ademuri/air-filter-controller/hardware/air-filter-controller.kicad_pcb

## KiCad design hardware/air-filter-controller.kicad_pcb (2025-01-30)

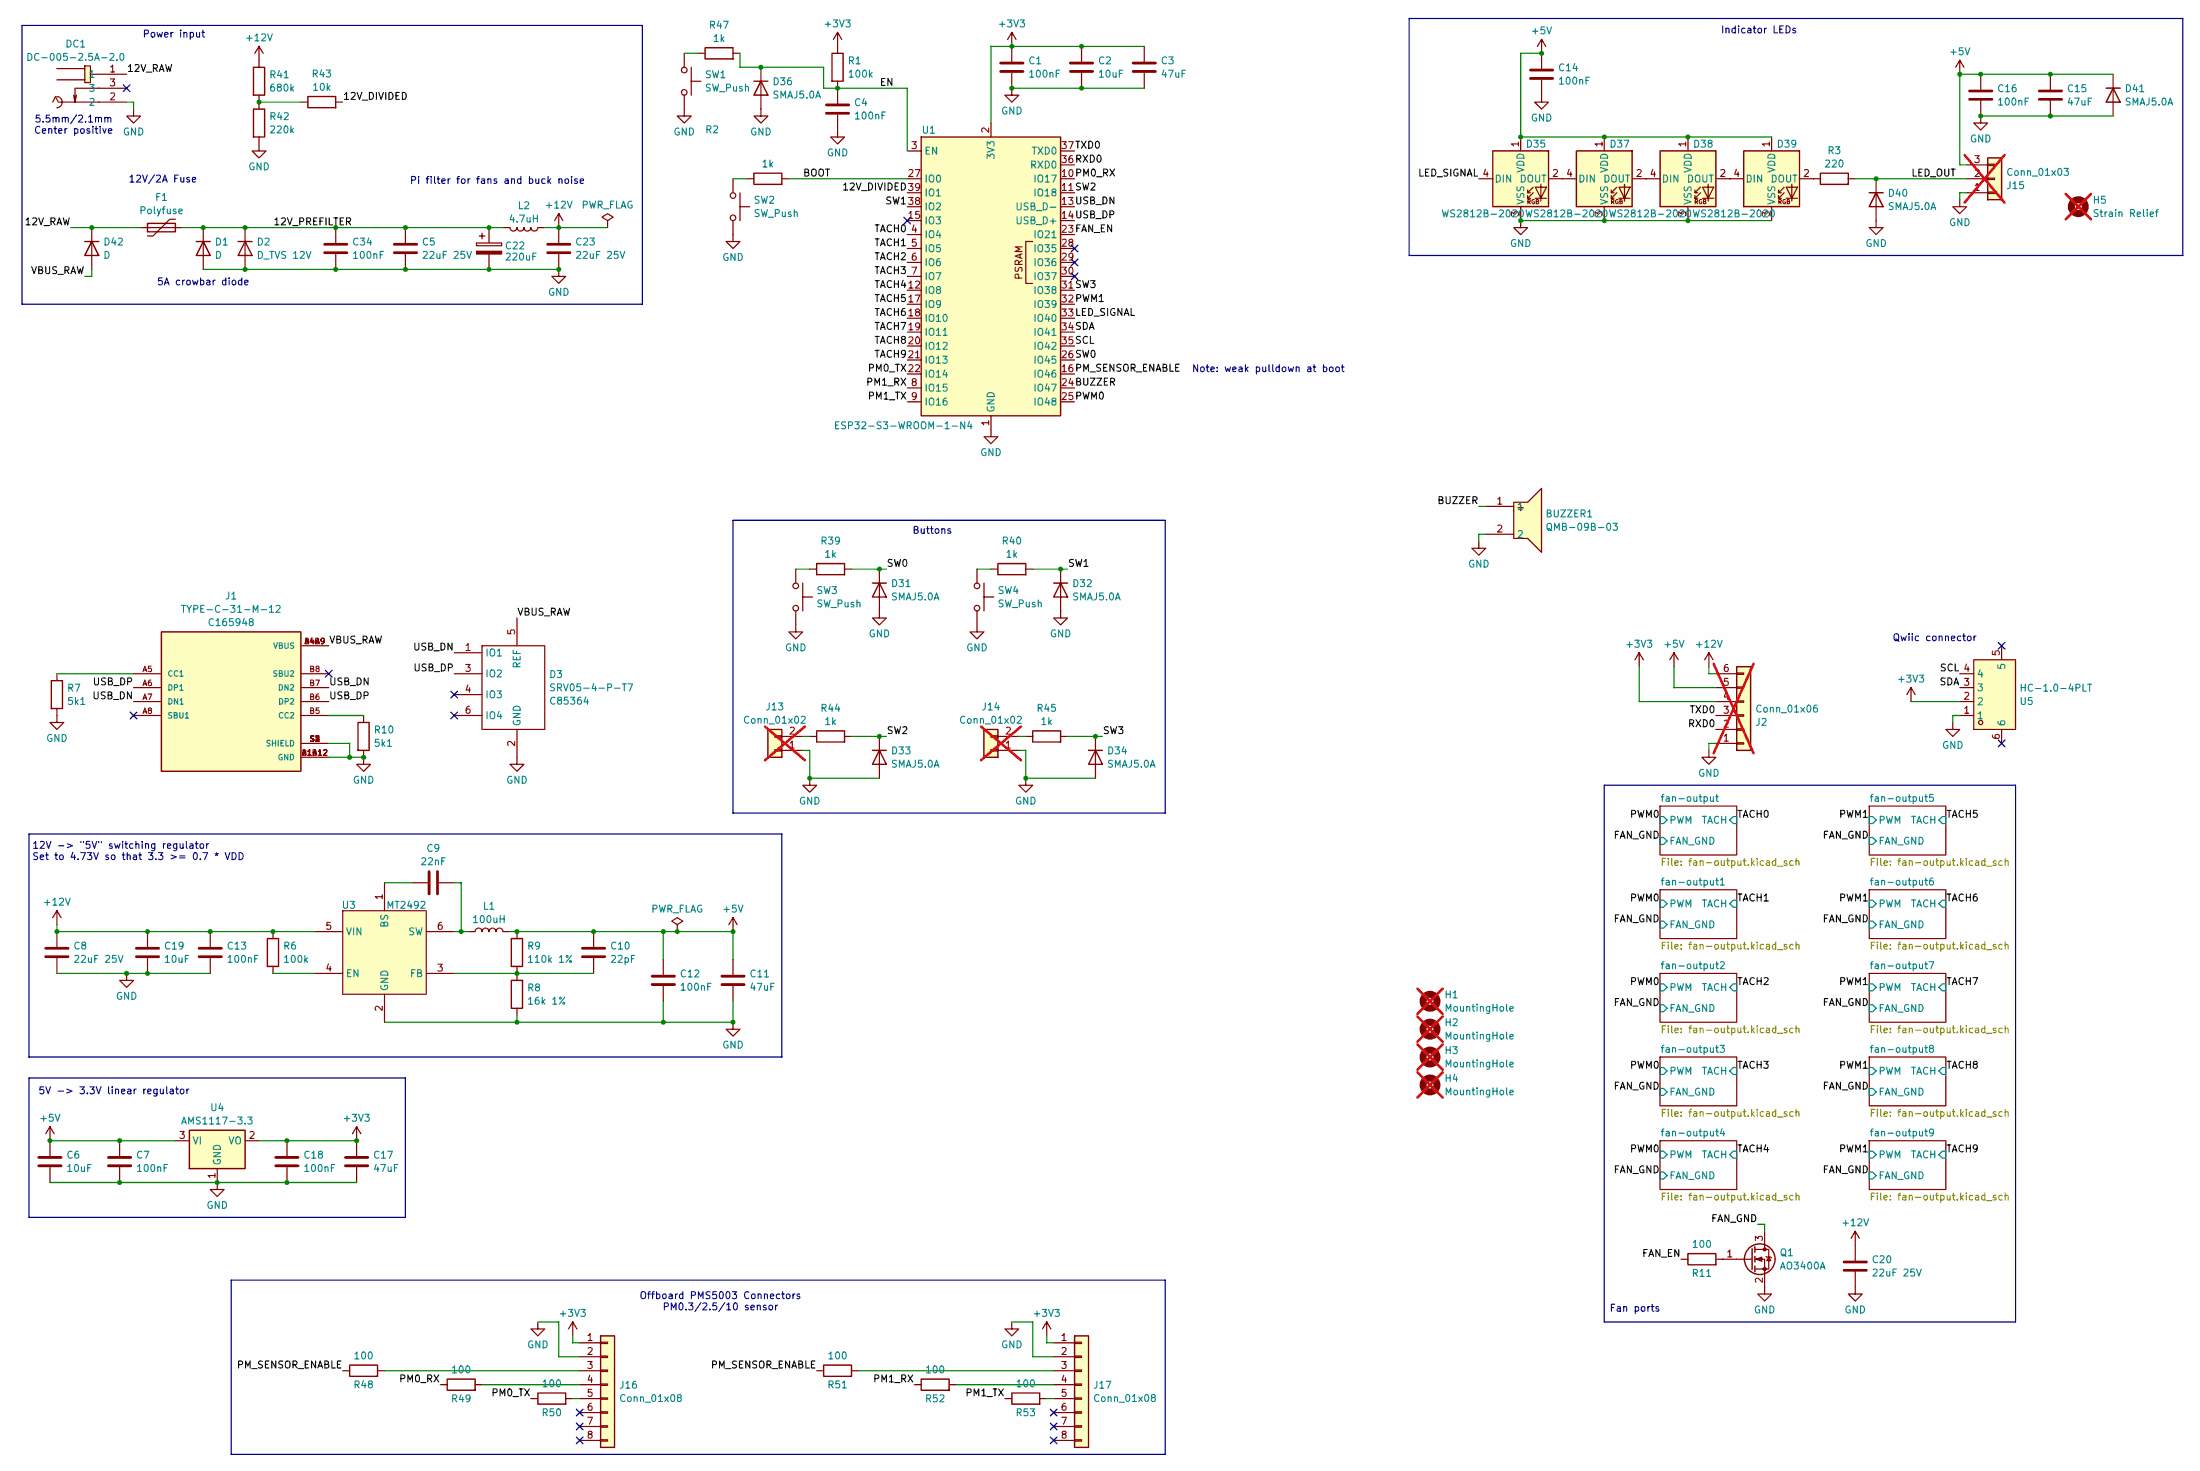
[picture p1: schematic air-filter-controller.kicad_sch]

Parts:
BUZZER1: QMB-09B-03; BUZ-TH_BD9.0-P4.00-D0.6-FD; LCSC C96256
C1, C4, C7, C12, C13, C14, C16, C18, C34: 100nF; C_0402_1005Metric; LCSC C307331
C2, C6, C19: 10uF; C_0603_1608Metric; LCSC C96446
C3, C11, C15, C17: 47uF; C_1206_3216Metric; LCSC C96123
C5, C8, C20, C23: 22uF 25V; C_1206_3216Metric; LCSC C12891
C9: 22nF; C_0402_1005Metric; LCSC C1532
C10: 22pF; C_0402_1005Metric; LCSC C1555
C22: 220uF; CP_Elec_8x10; LCSC C134765
D1, D42: D; D_SMA; MPN SS54; LCSC C22452
D2: D_TVS 12V; D_SMA; MPN SMAJ12A-E3/61; LCSC C89613
D3: SRV05-4-P-T7; SOT-23-6; LCSC C85364
D31, D32, D33, D34, D36, D40, D41: SMAJ5.0A; D_SMA; MPN SMAJ5.0A; LCSC C113952
D35, D37, D38, D39: WS2812B-2020; LED-SMD_4P-L2.0-W2.0-TL_WS2812B-2020; LCSC C965555
DC1: DC-005-2.5A-2.0; CONN-TH_DC-005-2.5A-2.0; LCSC C319099
F1: Polyfuse; Fuse_1812_4532Metric; MPN 1812L200/12DR; LCSC C315901
H1, H2, H3, H4: MountingHole; MountingHole_3.2mm_M3_ISO7380; not fitted
H5: Strain Relief; 3_pin_2.54mm_pitch_strain_relief; not fitted
J1: TYPE-C-31-M-12; HRO_TYPE-C-31-M-12; PARTREV A; LCSC C165948
J2: Conn_01x06; PinHeader_1x06_P2.54mm_Vertical; not fitted
J13, J14: Conn_01x02; PinHeader_1x02_P2.54mm_Vertical; not fitted
J15: Conn_01x03; PinHeader_1x03_P2.54mm_Vertical; not fitted
J16, J17: Conn_01x08; CONN-TH_8P-P1.25_HCTL_HC-1.25-8A; LCSC C2845526
L1: 100uH; L_Sunlord_SWPA8040S; MPN SWPA8065S101MT; LCSC C334254
L2: 4.7uH; L_Sunlord_SWPA4030S; MPN SWPA4030S4R7MT; LCSC C57269
Q1: AO3400A; SOT-23; LCSC C20917
R1, R6: 100k; R_0402_1005Metric; LCSC C25741
R2, R39, R40, R44, R45, R47: 1k; R_0402_1005Metric; LCSC C11702
R3: 220; R_0603_1608Metric_Pad0.98x0.95mm_HandSolder; LCSC C22962
R7, R10: 5k1; R_0402_1005Metric; LCSC C25905
R8: 16k 1%; R_0402_1005Metric; LCSC C25759
R9: 110k 1%; R_0402_1005Metric; LCSC C25745
R11: 100; R_0402_1005Metric; LCSC C25076
R41: 680k; R_0402_1005Metric; LCSC C4131
R42: 220k; R_0402_1005Metric; LCSC C25767
R43: 10k; R_0402_1005Metric; LCSC C25744
R48, R49, R50, R51, R52, R53: 100; R_0603_1608Metric_Pad0.98x0.95mm_HandSolder; LCSC C22775
SW1, SW2, SW3, SW4: SW_Push; SW_TACTILE_5.1MM_TS-1187A-C-D-B; LCSC C318884
U1: ESP32-S3-WROOM-1-N4; ESP32-S3-WROOM-1; LCSC C2913197
U3: MT2492; SOT-23-6_L2.9-W1.6-P0.95-LS2.8-BL; LCSC C89358
U4: AMS1117-3.3; SOT-223-3_TabPin2; LCSC C6186
U5: HC-1.0-4PLT; CONN-SMD_4P-P1.00_HC-1.0-4PLT; LCSC C2845372

Connections:
+3V3: C1.1, C2.1, C3.1, C17.1, C18.1, J2.4, J16.1, J17.1, R1.1, U1.2 (3V3), U4.2 (VO), U5.2; also elsewhere on the board
+5V: C6.1, C7.1, C10.2, C11.1, C12.1, C14.1, C15.1, C16.1, D35.1 (VDD), D37.1 (VDD), D38.1 (VDD), D39.1 (VDD), D41.1 (K), J2.5, J15.3, L1.2, R9.1, U4.3 (VI)
+12V: C8.1, C13.1, C19.1, C20.1, C23.1, J2.6, L2.1, R6.1, R41.1, U3.5 (VIN); also elsewhere on the board
/12V_DIVIDED: R43.2, U1.39 (IO1)
/12V_PREFILTER: C5.1, C22.1, C34.1, D1.1 (K), D2.1 (K), F1.2, L2.2
/12V_RAW: D42.1 (K), DC1.1, F1.1
/BOOT: R2.2, U1.27 (IO0)
/BUZZER: BUZZER1.1, U1.24 (IO47)
/EN: C4.1, D36.1 (K), R1.2, R47.2, U1.3 (EN)
/FAN_EN: R11.1, U1.23 (IO21)
/FAN_GND: Q1.3 (D); also elsewhere on the board
/LED_OUT: D40.1 (K), J15.2, R3.2
/LED_SIGNAL: D35.4 (DIN), U1.33 (IO40)
/PM0_RX: R49.1, U1.10 (IO17)
/PM0_TX: R50.1, U1.22 (IO14)
/PM1_RX: R52.1, U1.8 (IO15)
/PM1_TX: R53.1, U1.9 (IO16)
/PM_SENSOR_ENABLE: R48.1, R51.1, U1.16 (IO46)
/PWM0: U1.25 (IO48); also elsewhere on the board
/PWM1: U1.32 (IO39); also elsewhere on the board
/RXD0: J2.2, U1.36 (RXD0)
/SCL: U1.35 (IO42), U5.4
/SDA: U1.34 (IO41), U5.3
/SW0: D31.1 (K), R39.2, U1.26 (IO45)
/SW1: D32.1 (K), R40.2, U1.38 (IO2)
/SW2: D33.1 (K), R44.2, U1.11 (IO18)
/SW3: D34.1 (K), R45.2, U1.31 (IO38)
/TACH0: U1.4 (IO4); also elsewhere on the board
/TACH1: U1.5 (IO5); also elsewhere on the board
/TACH2: U1.6 (IO6); also elsewhere on the board
/TACH3: U1.7 (IO7); also elsewhere on the board
/TACH4: U1.12 (IO8); also elsewhere on the board
/TACH5: U1.17 (IO9); also elsewhere on the board
/TACH6: U1.18 (IO10); also elsewhere on the board
/TACH7: U1.19 (IO11); also elsewhere on the board
/TACH8: U1.20 (IO12); also elsewhere on the board
/TACH9: U1.21 (IO13); also elsewhere on the board
/TXD0: J2.3, U1.37 (TXD0)
/USB_DN: D3.1 (IO1), J1.A7 (DN1), J1.B7 (DN2), U1.13 (USB_D-)
/USB_DP: D3.3 (IO2), J1.A6 (DP1), J1.B6 (DP2), U1.14 (USB_D+)
/VBUS_RAW: D3.5 (REF), D42.2 (A), J1.A4B9 (VBUS), J1.B4A9 (VBUS)
GND: BUZZER1.2, C1.2, C2.2, C3.2, C4.2, C5.2, C6.2, C7.2, C8.2, C11.2, C12.2, C13.2, C14.2, C15.2, C16.2, C17.2, C18.2, C19.2, C20.2, C22.2, C23.2, C34.2, D1.2 (A), D2.2 (A), D3.2 (GND), D31.2 (A), D32.2 (A), D33.2 (A), D34.2 (A), D35.3 (VSS), D36.2 (A), D37.3 (VSS), D38.3 (VSS), D39.3 (VSS), D40.2 (A), D41.2 (A), DC1.2, J1.A1B12 (GND), J1.B1A12 (GND), J1.S1 (SHIELD), J1.S2 (SHIELD), J1.S3 (SHIELD), J1.S4 (SHIELD), J2.1, J13.1, J14.1, J15.1, J16.2, J17.2, Q1.2 (S), R7.2, R8.1, R10.2, R42.2, SW1.2, SW2.2, SW3.2, SW4.2, U1.1 (GND), U1.40 (GND), U1.41 (GND), U3.2 (GND), U4.1 (GND), U5.1; also elsewhere on the board
unnamed: D35.2 (DOUT), D37.4 (DIN)
unnamed: D37.2 (DOUT), D38.4 (DIN)
unnamed: D38.2 (DOUT), D39.4 (DIN)
unnamed: D39.2 (DOUT), R3.1
unnamed: J1.A5 (CC1), R7.1
unnamed: J1.B5 (CC2), R10.1
unnamed: J13.2, R44.1
unnamed: J14.2, R45.1
unnamed: J16.3, R48.2
unnamed: J16.4, R49.2
unnamed: J16.5, R50.2
unnamed: J17.3, R51.2
unnamed: J17.4, R52.2
unnamed: J17.5, R53.2
unnamed: Q1.1 (G), R11.2
unnamed: R2.1, SW2.1
unnamed: R39.1, SW3.1
unnamed: R40.1, SW4.1
unnamed: R41.2, R42.1, R43.1
unnamed: R47.1, SW1.1
unnamed: C9.1, U3.1 (BS)
unnamed: R6.2, U3.4 (EN)
unnamed: C10.1, R8.2, R9.2, U3.3 (FB)
unnamed: C9.2, L1.1, U3.6 (SW)

Notes on the sheet:
Power input
Fan ports
Note: weak pulldown at boot
Pi filter for fans and buck noise
5.5mm/2.1mm Center positive
5V -> 3.3V linear regulator
Qwiic connector
12V -> "5V" switching regulator Set to 4.73V so that 3.3 >= 0.7 * VDD
Offboard PMS5003 Connectors PM0.3/2.5/10 sensor
5A crowbar diode
12V/2A Fuse
Indicator LEDs
Buttons

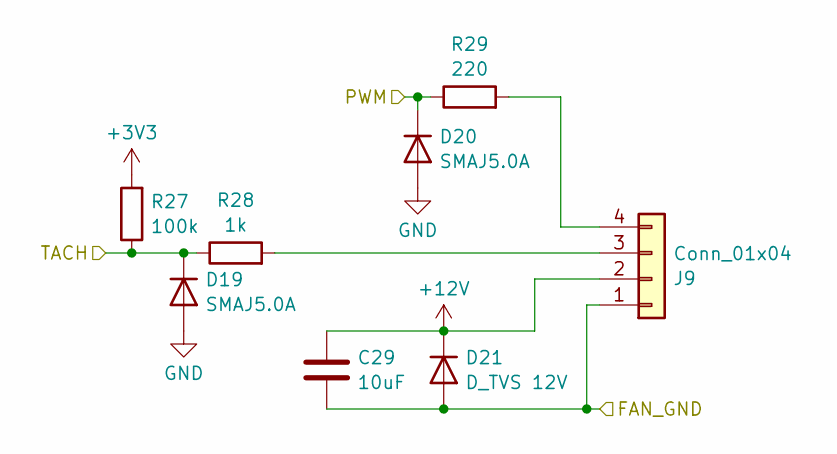
[picture p2: schematic fan-output.kicad_sch]

Parts:
C29: 10uF; C_0603_1608Metric; LCSC C96446
D19, D20: SMAJ5.0A; D_SMA; MPN SMAJ5.0A; LCSC C113952
D21: D_TVS 12V; D_SMA; MPN SMAJ12A-E3/61; LCSC C89613
J9: Conn_01x04; CONN-TH_47053-1000; MPN 470531000; LCSC C240840
R27: 100k; R_0603_1608Metric_Pad0.98x0.95mm_HandSolder; LCSC C25803
R28: 1k; R_0402_1005Metric; LCSC C11702
R29: 220; R_0603_1608Metric_Pad0.98x0.95mm_HandSolder; LCSC C22962

Connections:
+3V3: R27.2; also elsewhere on the board
+12V: C29.1, D21.1 (K), J9.2; also elsewhere on the board
/FAN_GND: C29.2, D21.2 (A), J9.1; also elsewhere on the board
/PWM1: D20.1 (K), R29.1; also elsewhere on the board
/TACH5: D19.1 (K), R27.1, R28.1; also elsewhere on the board
GND: D19.2 (A), D20.2 (A); also elsewhere on the board
unnamed: J9.3, R28.2
unnamed: J9.4, R29.2

Parts of its further copies:
C24, C25, C26, C27, C28, C30, C31, C32, C33: 10uF; C_0603_1608Metric; LCSC C96446
D4, D9, D12, D15, D18, D24, D27, D30, D45: D_TVS 12V; D_SMA; MPN SMAJ12A-E3/61; LCSC C89613
D5, D6, D7, D8, D10, D11, D13, D14, D16, D17, D22, D23, D25, D26, D28, D29, D43, D44: SMAJ5.0A; D_SMA; MPN SMAJ5.0A; LCSC C113952
J3, J4, J5, J6, J7, J8, J10, J11, J12: Conn_01x04; CONN-TH_47053-1000; MPN 470531000; LCSC C240840
R4, R12, R15, R18, R21, R24, R30, R33, R36: 100k; R_0603_1608Metric_Pad0.98x0.95mm_HandSolder; LCSC C25803
R5, R13, R16, R19, R22, R25, R31, R34, R37: 1k; R_0402_1005Metric; LCSC C11702
R14, R17, R20, R23, R26, R32, R35, R38, R46: 220; R_0603_1608Metric_Pad0.98x0.95mm_HandSolder; LCSC C22962

Connections of its further copies:
+3V3: R4.2, R12.2, R15.2, R18.2, R21.2, R24.2, R30.2, R33.2, R36.2; also elsewhere on the board
+12V: C24.1, C25.1, C26.1, C27.1, C28.1, C30.1, C31.1, C32.1, C33.1, D4.1 (K), D9.1 (K), D12.1 (K), D15.1 (K), D18.1 (K), D24.1 (K), D27.1 (K), D30.1 (K), D45.1 (K), J3.2, J4.2, J5.2, J6.2, J7.2, J8.2, J10.2, J11.2, J12.2; also elsewhere on the board
/FAN_GND: C24.2, C25.2, C26.2, C27.2, C28.2, C30.2, C31.2, C32.2, C33.2, D4.2 (A), D9.2 (A), D12.2 (A), D15.2 (A), D18.2 (A), D24.2 (A), D27.2 (A), D30.2 (A), D45.2 (A), J3.1, J4.1, J5.1, J6.1, J7.1, J8.1, J10.1, J11.1, J12.1; also elsewhere on the board
/PWM0: D6.1 (K), D8.1 (K), D11.1 (K), D14.1 (K), D17.1 (K), R14.1, R17.1, R20.1, R23.1, R26.1; also elsewhere on the board
/PWM1: D23.1 (K), D26.1 (K), D29.1 (K), D44.1 (K), R32.1, R35.1, R38.1, R46.1; also elsewhere on the board
/TACH0: D5.1 (K), R13.1, R15.1; also elsewhere on the board
/TACH1: D7.1 (K), R12.1, R16.1; also elsewhere on the board
/TACH2: D10.1 (K), R18.1, R19.1; also elsewhere on the board
/TACH3: D13.1 (K), R21.1, R22.1; also elsewhere on the board
/TACH4: D16.1 (K), R24.1, R25.1; also elsewhere on the board
/TACH6: D22.1 (K), R30.1, R31.1; also elsewhere on the board
/TACH7: D25.1 (K), R33.1, R34.1; also elsewhere on the board
/TACH8: D28.1 (K), R36.1, R37.1; also elsewhere on the board
/TACH9: D43.1 (K), R4.1, R5.1; also elsewhere on the board
GND: D5.2 (A), D6.2 (A), D7.2 (A), D8.2 (A), D10.2 (A), D11.2 (A), D13.2 (A), D14.2 (A), D16.2 (A), D17.2 (A), D22.2 (A), D23.2 (A), D25.2 (A), D26.2 (A), D28.2 (A), D29.2 (A), D43.2 (A), D44.2 (A); also elsewhere on the board
unnamed: J3.3, R16.2
unnamed: J3.4, R17.2
unnamed: J4.3, R5.2
unnamed: J4.4, R46.2
unnamed: J5.3, R13.2
unnamed: J5.4, R14.2
unnamed: J6.3, R19.2
unnamed: J6.4, R20.2
unnamed: J7.3, R22.2
unnamed: J7.4, R23.2
unnamed: J8.3, R25.2
unnamed: J8.4, R26.2
unnamed: J10.3, R31.2
unnamed: J10.4, R32.2
unnamed: J11.3, R34.2
unnamed: J11.4, R35.2
unnamed: J12.3, R37.2
unnamed: J12.4, R38.2

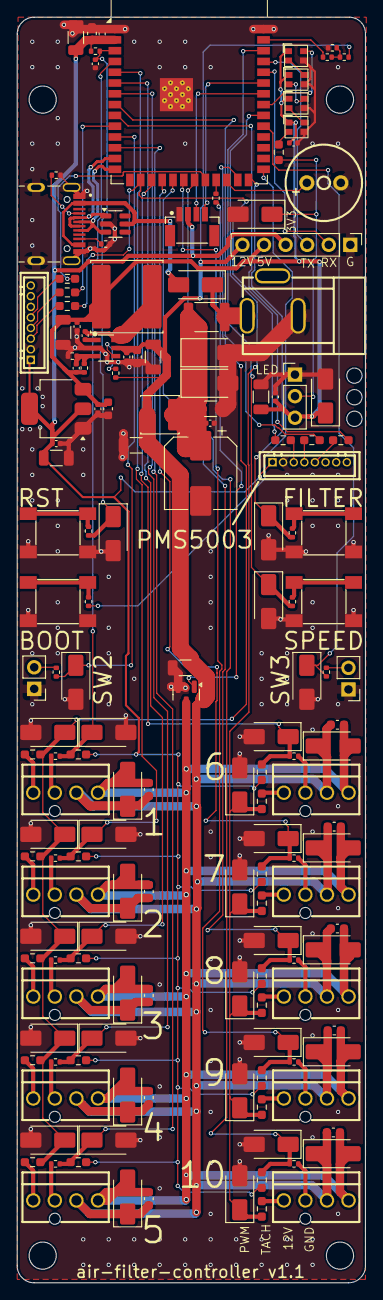
[picture p3: board air-filter-controller.kicad_pcb from above]

Board: 4 copper layers, 41.0 x 149.0 mm, 167 parts (0 on the bottom side), 86 nets.
