ademuri/air-filter-controller/(commit log)

2024-06-15 Start adding schematic
    [air-filter-controller.kicad_pcb, air-filter-controller.kicad_sch]
2024-06-15 First pass at schematic
    [air-filter-controller.kicad_sch, fan-output.kicad_sch]
2024-06-15 Add buzzer
    [air-filter-controller.kicad_sch]
2024-06-18 Start placement and routing
    [air-filter-controller.kicad_pcb, air-filter-controller.kicad_sch, fan-output.kicad_sch]
2024-06-30 Routing and placement done
    [air-filter-controller.kicad_pcb, air-filter-controller.kicad_sch]
2024-06-30 Hardware v1.0
    [air-filter-controller.kicad_pcb, air-filter-controller.kicad_sch, bom.csv, designators.csv, positions.csv]
2024-06-30 Add basic ESPHome template.
    This sets up the platform config, and includes the buzzer.
    [air-filter-controller-template.yaml]
2024-07-03 WIP configure some of ESPHome
    [air-filter-controller-template.yaml]
2024-07-07 Configure buzzer and one tach
    [air-filter-controller-template.yaml]
2024-07-13 WIP debug BMP280
    [air-filter-controller-template.yaml]
2024-07-18 Configure BMP280 (forked repo) and buttons
    [air-filter-controller-template.yaml]
2024-07-18 Simplify fan power control
    [air-filter-controller-template.yaml]
2024-07-18 Add filter runtime monitoring
    [air-filter-controller-template.yaml]
2024-07-18 Rename template
    [template-air-filter-controller.yaml]
2024-07-19 Add script for measuring filter pressure drop
    [template-air-filter-controller.yaml]
2024-07-19 Set units for pressure drop
    [template-air-filter-controller.yaml]
2024-07-21 Add scripts for logging pressure changes
    [template-air-filter-controller.yaml]
2024-07-22 Improve filter test routine
    [template-air-filter-controller.yaml]
2024-08-07 Export max tach sensor
    [template-air-filter-controller.yaml]
2024-08-07 Increase update interval for time since filter check
    [template-air-filter-controller.yaml]
2024-08-09 Toggle speeds when speed button is pressed
    [template-air-filter-controller.yaml]
2024-10-20 Remove BMP280 from config
    [template-air-filter-controller.yaml]
2024-10-20 Add remaining tachos
    [template-air-filter-controller.yaml]
2024-10-25 Add min tach logic
    [template-air-filter-controller.yaml]
2024-10-25 Add local min tach functionality
    [template-air-filter-controller.yaml]
2024-10-27 Update schematic for v1.1
    [air-filter-controller.kicad_sch, fan-output.kicad_sch]
2024-10-31 More schematic updates for v1.1
    [air-filter-controller.kicad_sch, fan-output.kicad_sch]
2024-12-28 More schematic updates for v1.1:
    - Add connectors for offboard PMS5003 sensors
    - Add ADP2100 differential pressure sensor
    [air-filter-controller.kicad_sch]
2024-12-29 v1.1: start updating layout
    [air-filter-controller.kicad_pcb, air-filter-controller.kicad_sch]
2024-12-30 Hardware revision v1.1:
    - Fix flipped USB lines
    - Remove diode on BOOT switch
    - Remove buzzer resistor
    - Change voltage divider to ADC channel 1
    - Increased from 9 to 10 fan channels
    - Switched to addressable LEDs
    - Added connector for offboard WS2812 LEDs
    - Added a Qwiic connector
    - Added two connectors for PMS5003 particle sensors
    [air-filter-controller.kicad_pcb, air-filter-controller.kicad_sch, bom.csv, designators.csv, positions.csv]
2025-01-06 WIP address conducted emissions
    [air-filter-controller.kicad_sch]
2025-01-30 Hardware v1.1
    [air-filter-controller.kicad_pcb, air-filter-controller.kicad_sch, bom.csv, designators.csv, fan-output.kicad_sch, positions.csv]
2025-01-30 Update pins for v1.1
    [template-air-filter-controller.yaml]
2025-01-30 Add PMS5003
    [template-air-filter-controller.yaml]
2025-03-27 Update template metadata
    [template-air-filter-controller.yaml]
2025-03-27 Add filter runtime reset functionality
    [template-air-filter-controller.yaml]
2025-06-20 Add sensor for template version
    [template-air-filter-controller.yaml]
